PSUCAPSTONE2016GSMGROUP/SMSProject/FullSizeRender.jpg.jpeg

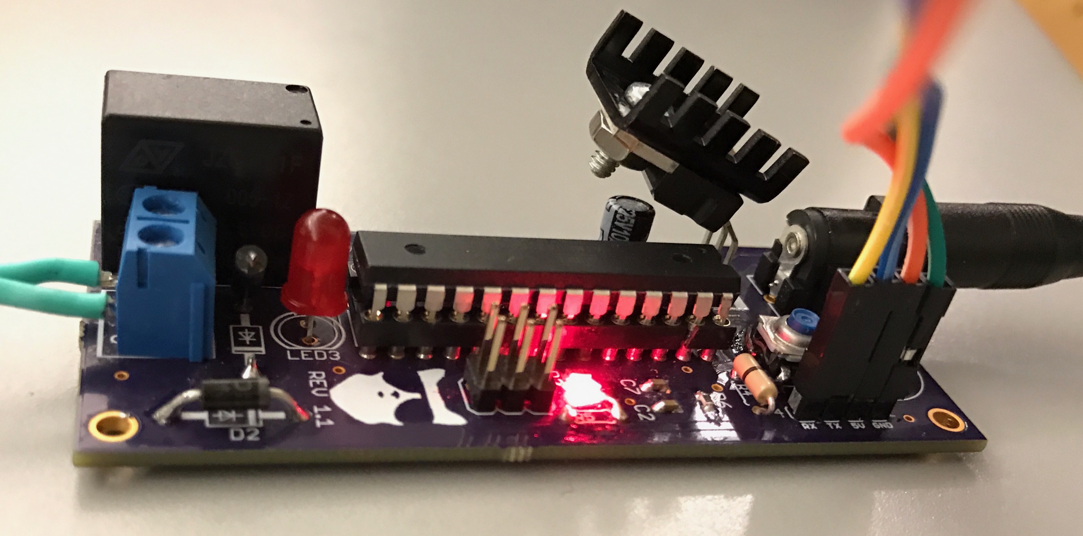
FullSizeRender.jpg.jpeg
