PSUCAPSTONE2016GSMGROUP/SMSProject/README.md

# SMSProject

This is a test of adding some code to the initial README.md file in the "master" branch.
Changes are being made in the readme-edits branch which was just created.
