PSUCAPSTONE2016GSMGROUP/SMSProject/Images/Bottom OSH Park .png

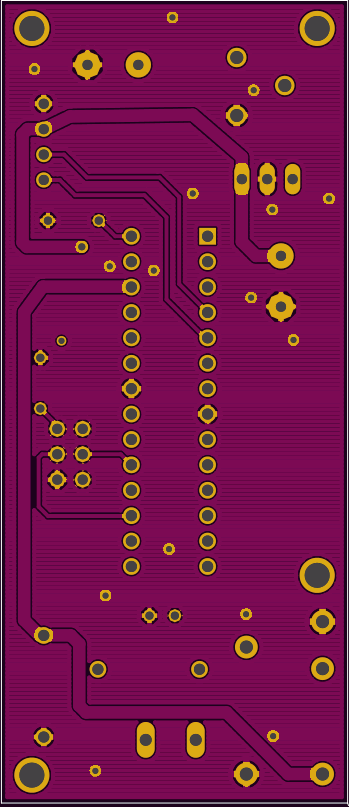
Images/Bottom OSH Park .png
