PSUCAPSTONE2016GSMGROUP/SMSProject/Images/Bottom-Rev1.1.png

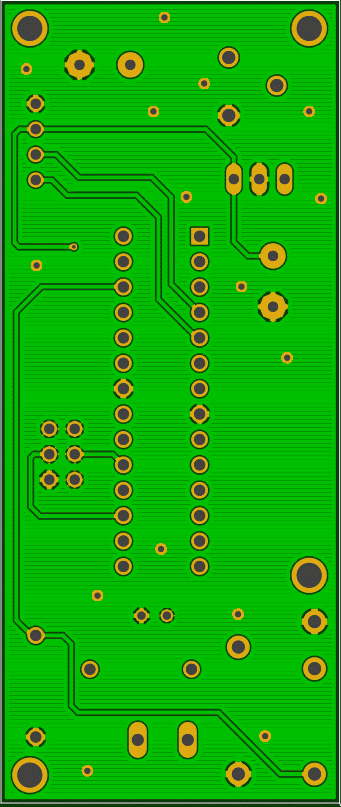
Images/Bottom-Rev1.1.png
