PSUCAPSTONE2016GSMGROUP/SMSProject/Images/COOL-CAT.bmp

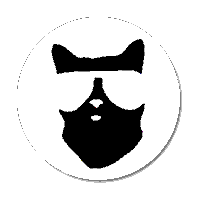
Images/COOL-CAT.bmp
