PSUCAPSTONE2016GSMGROUP/SMSProject/Images/Top-OSH Park.png

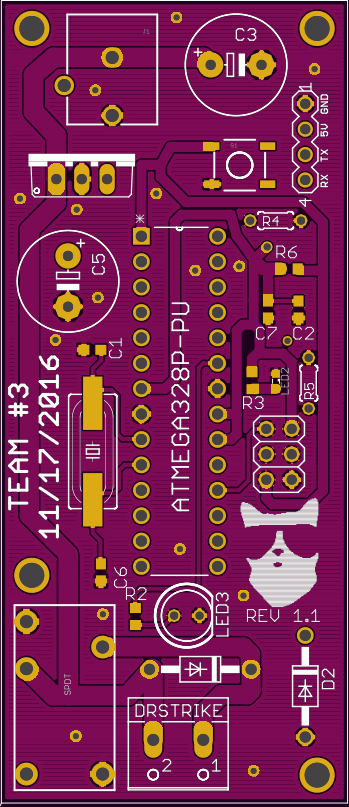
Images/Top-OSH Park.png
