PSUCAPSTONE2016GSMGROUP/SMSProject/Images/Top-Rev1.1.png

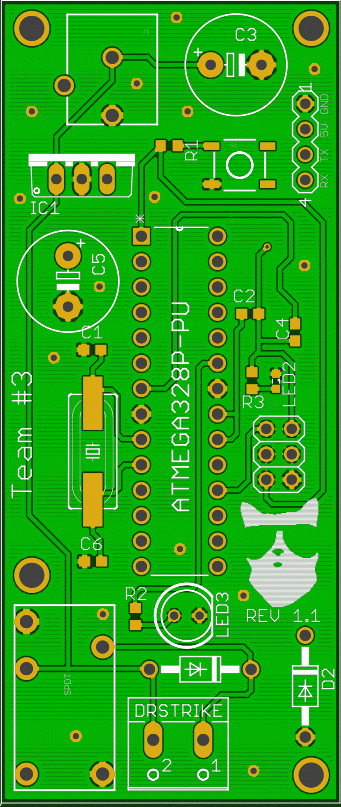
Images/Top-Rev1.1.png
