PSUCAPSTONE2016GSMGROUP/SMSProject/T03-BOM.xls

 | BOM: Group 3 | Rev: 4
Qty | Value | Device | Package | Parts | Description | Link | Price (each) | Price (total)
1 | N/A | LED5MM | LED5MM | LED3 | 5MM LED | Sparkfun (https://www.sparkfun.com/products/9590) | $0.35 | $0.35
1 | N/A | LEDSML0603 | SML0603 | LED2 | SURFACE MOUNT LED | Digikey (http://www.digikey.com/product-detail/en/lite-on-inc/LTST-C191KRKT/160-1447-1-ND/386836) | $0.21 | $0.21
1 | N/A | W237-102 | W237-102 | DRSTRIKE | WAGO SCREW CLAMP | Sparkfun (https://www.sparkfun.com/products/8084) | $0.95 | $0.95
1 | 10k | R-US_R0603 | R0603 | R1 | RESISTOR | Digikey (http://www.digikey.com/product-detail/en/stackpole-electronics-inc/RMCF0603JT10K0/RMCF0603JT10K0CT-ND/1943191) | $0.10 | $0.10
2 | 10u | CPOL-EUE5-10.5 | E5-10,5 | C3, C5 | POLARIZED CAPACITOR | Sparkfun (https://www.sparkfun.com/products/523) | $0.45 | $0.90
1 | 16M | CRYSTALHC49UP | HC49UP | Q2 | CRYSTAL | Digikey (http://www.digikey.com/product-detail/en/abracon-llc/ABLS-16.000MHZ-B4-T/535-10226-1-ND/2184261) | $0.21 | $0.21
2 | 1N4004 | 1N4004 | DO41-10 | D1 | DIODE | Mouser (http://www.mouser.com/ProductDetail/Diodes-Incorporated/1N4007-T/?qs=e%2FRqmsgwm9iVtgJYUW23AA%3D%3D) | $0.13 | $0.26
2 | 220 | R-US_R0603 | R0603 | R2, R3 | RESISTOR | Digikey (http://www.digikey.com/product-detail/en/vishay-dale/RCL0406220RFKEA/541-1944-1-ND/4741200) | $0.16 | $0.32
2 | 22p | C-EUC0603 | C0603 | C1, C6 | CAPACITOR | Mouser (http://www.mouser.com/ProductDetail/AVX/MM031A220JCT2A/) | $0.03 | $0.06
1 | 788TV | 788TV | TO220V | IC1 | Positive VOLTAGE REGULATOR | Sparkfun (https://www.sparkfun.com/products/12766) | $1.50 | $1.50
1 | ATMEGA328P-PU | ATMEGA328P-PU | DIP254P762X457-28 | U1 | 8-BIT MICROCONTROLLER | Sparkfun (https://www.sparkfun.com/products/9061) | $4.30 | $4.30
1 | AVR_SPI_PRG_62X3_LOCK | AVR_SPI_PRG_62X3_LOCK | 2X3_LOCK | J2 | AVR ISP 6 Pin | Sparkfun (https://www.sparkfun.com/products/12807) | $0.50 | $0.50
1 | POWER_JACKPTH_BREAD | POWER_JACKPTH_BREAD | POWER_JACK_PTH_BREAD | J1 | POWER JACK | Sparkfun (https://www.sparkfun.com/products/10811) | $0.95 | $0.95
1 | RELAYPTH4 | RELAYPTH4 | RELAY-JZC | SPDT | SPDT relay (COM-00101) | Sparkfun (https://www.sparkfun.com/products/100) | $1.95 | $1.95
1 | TAC_SWITCHSMD | TAC_SWITCHSMD | TACTILE-SWITCH-SMD | S1 | Momentary Switch | Sparkfun (https://www.sparkfun.com/products/97) | $0.35 | $0.35
1 | N/A | UHPPOTE ELECTRIC STRIKE | N/A | N/A | ELECTRIC DOOR STRIKE | Amazon (https://www.amazon.com/dp/B00V45GWTI/ref=nav_timeline_asin?_encoding=UTF8&psc=1) | $24.20 | $24.20
1 | N/A | GSM GPRS | N/A | N/A | SAINSMART SMALL GSM GPRS SIM900 | Amazon (https://www.amazon.com/gp/product/B00TEUAJMQ/ref=oh_aui_detailpage_o03_s00?ie=UTF8&psc=1) | $28.99 | $28.99
2 | 100n | C-EUC0603 | C0603 | C2,C7 | CAPACITOR | Mouser (http://www.mouser.com/ProductDetail/Murata-Electronics/GRM188R71E104KA01D/?qs=kZszf6EFsb%2BcS4JW42Ze0A==) | $0.02 | $0.04
2 | 0 | R-US_0204/5 (R-US_) | 0204/5 | R4,R5 | RESISTOR | Digikey (http://www.digikey.com/product-detail/en/yageo/ZOR-25-B-52-0R/0.0QBK-ND/18794) | $0.07 | $0.14
1 | N/A | N/A | N/A | N/A | 12V REGULATED POWERSUPPLY | BLMS (http://www.bitcheslovemyswitches.com/) | $7.00 | $7.00
1 | N/A | N/A | N/A | N/A | PRINTED CIRCUIT BOARD | OSH Park (https://oshpark.com/) | 5.41 | $5.41
 |  |  |  |  |  | TOTAL COST PER UNIT: |  | $78.69
