PSUCAPSTONE2016GSMGROUP/SMSProject/T03-GSM-Schematic.brd

## EAGLE design T03-GSM-Schematic.brd (2016-11-17)

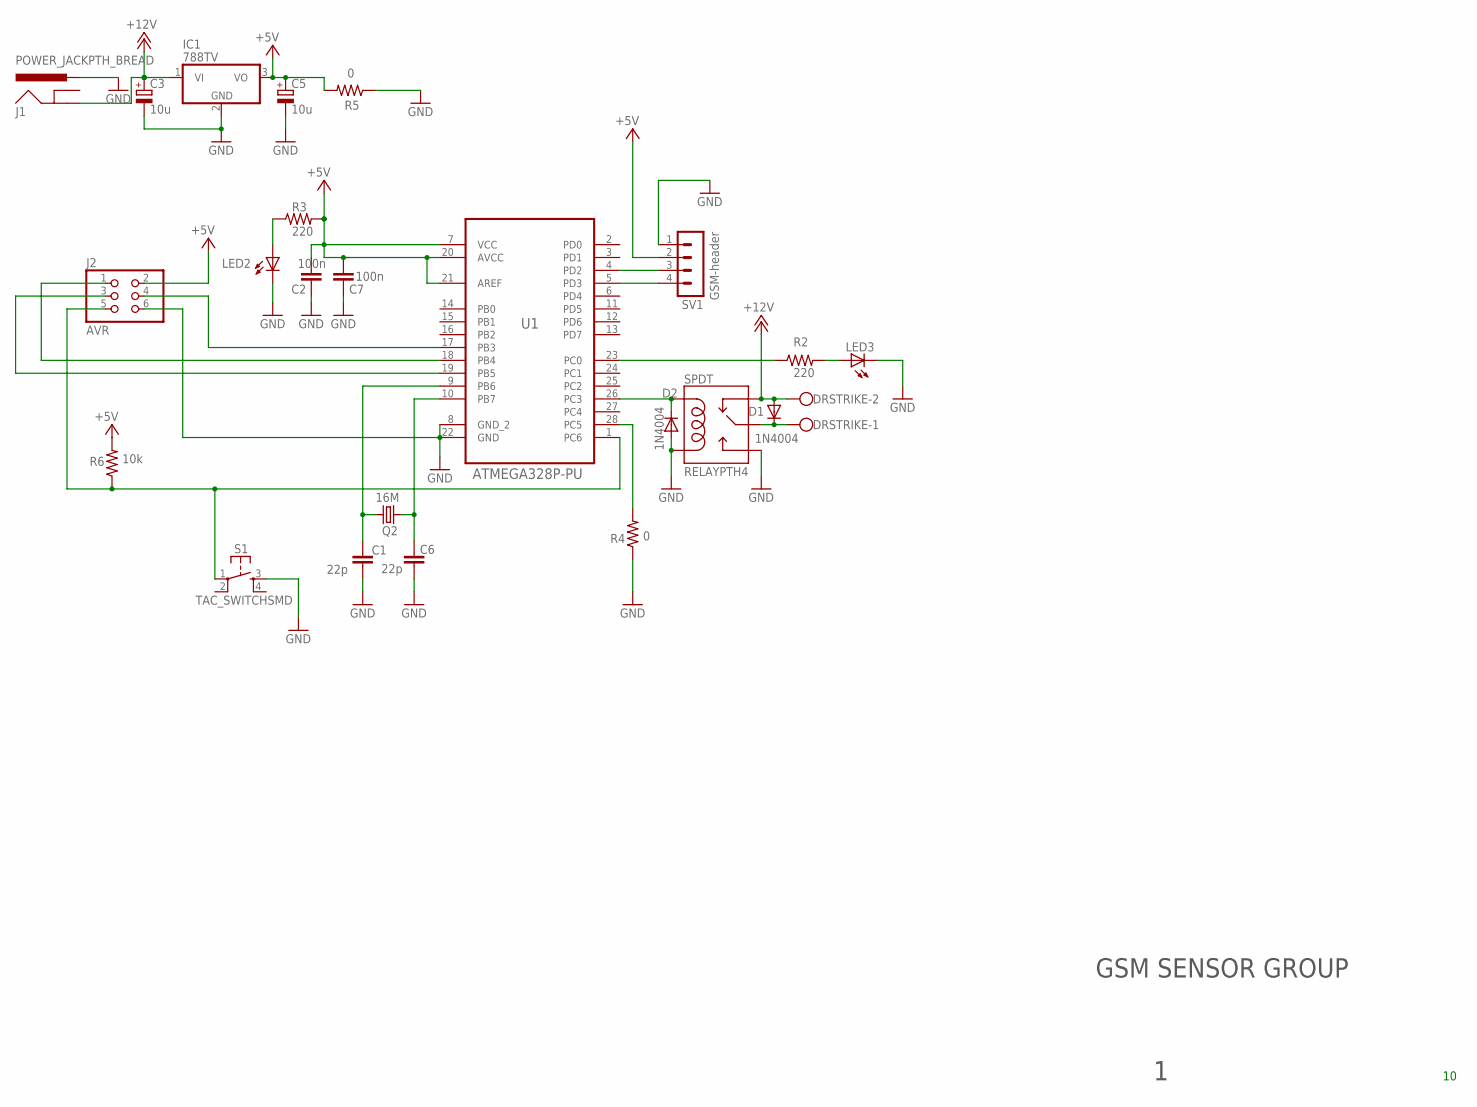
[picture p11: schematic T03-GSM-Schematic.sch]

Parts:
C1, C6: 22p; C0603
C2, C7: 100n; C0603
C3, C5: 10u; E5-10,5
D1, D2: 1N4004; DO41-10
DRSTRIKE: W237-102
IC1: 788TV; TO220V
J1: POWER_JACKPTH_BREAD; POWER_JACK_PTH_BREAD
J2: AVR; 2X03
LED2: LEDSML0603; SML0603
LED3: LED5MM
Q2: 16M; HC49UP
R2, R3: 220; R0603
R4, R5: 0; 0204/5
R6: 10k; R0603
S1: TAC_SWITCHSMD; TACTILE-SWITCH-SMD
SPDT: RELAYPTH4; RELAY-JZC
SV1: GSM-header; MA04-1
U1: ATMEGA328P-PU; DIP254P762X457-28

Connections:
+5V: C2.2, C5.+, C7.2, IC1.3 (VO), J2.2, R3.2, R5.2, R6.2, SV1.2, U1.7 (VCC), U1.20 (AVCC), U1.21 (AREF)
+12V: C3.+, D1.A, DRSTRIKE.2, IC1.1 (VI), J1.GND, SPDT.2 (NC)
GND: C1.2, C2.1, C3.-, C5.-, C6.2, C7.1, D2.A, IC1.2 (GND), J1.PWR, J2.6, LED2.C, LED3.K (C), R4.1, R5.1, S1.3, SPDT.1 (COIL2), SPDT.3 (NO), SV1.1, U1.8 (GND_2), U1.22 (GND)
unnamed: J2.5, R6.1, S1.1, U1.1 (PC6)
unnamed: LED2.A, R3.1
unnamed: D1.C, DRSTRIKE.1, SPDT.4 (MAIN)
unnamed: J2.3, U1.19 (PB5)
unnamed: LED3.A, R2.2
unnamed: J2.4, U1.17 (PB3)
unnamed: J2.1, U1.18 (PB4)
unnamed: R2.1, U1.23 (PC0)
unnamed: R4.2, U1.28 (PC5)
unnamed: D2.C, SPDT.5 (COIL1), U1.26 (PC3)
unnamed: C1.1, Q2.2, U1.9 (PB6)
unnamed: C6.1, Q2.1, U1.10 (PB7)
RX: SV1.4, U1.5 (PD3)
TX: SV1.3, U1.4 (PD2)

Notes on the sheet:
GSM SENSOR GROUP

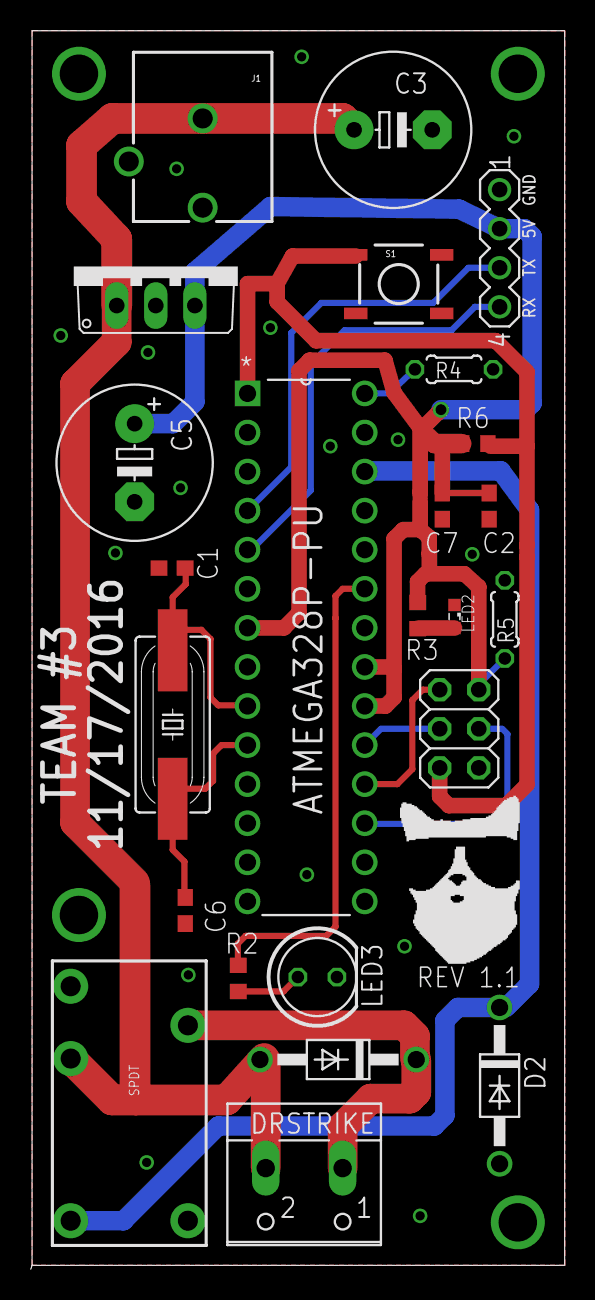
[picture p12: board T03-GSM-Schematic.brd from above]

Board: 2 copper layers, 34.6 x 80.3 mm, 24 parts (0 on the bottom side), 17 nets.
