PSUCAPSTONE2016GSMGROUP/SMSProject/(commit log)

2016-11-03 Cleaned up the schematic and fixed ERC errors
    [GSM Schematic.sch]
2016-11-03 Update GSM Schematic.sch
    [GSM Schematic.sch]
2016-11-05 Add files via upload
    Fixed the relay to door strike connection and replaced terminals with 237-102 WAGO terminal blocks
    [GSM Schematic.sch]
2016-11-07 updated the Schematic and changed PCB layout
    Updated the Schematic and included a surface mount for the Voltage regulator and changed the layout of the PCB and added a logo to it
    [GSM Schematic.brd, GSM Schematic.sch]
2016-11-08 Changed the logo location and added Revision #
    DRC errors down to 49 (All of the errors are Stop Errors)
    [GSM Schematic.brd]
2016-11-08 Arranged names for components
    [GSM Schematic.brd]
2016-11-08 Fixed DRC errors - Down to 10 errors
    [GSM Schematic.brd]
2016-11-09 Add files via upload
    Added diode to door strike output and cleaned up breadboard lines.
    Also solved consistency errors
    [GSM Schematic.sch]
2016-11-09 Made board and schematic consistent - no ERC erros
    [GSM Schematic.brd, GSM Schematic.sch]
2016-11-09 Fixed some DRC errors
    Down to 10 errors again
    [GSM Schematic.brd]
2016-11-09 timed and added mounting holes
    [GSM Schematic.brd]
2016-11-10 Fixed DRC errors and added dimensions
    [GSM Schematic.brd]
2016-11-10 Renamed file to meet the specification
    [T03-GSM-Schematic.brd]
2016-11-10 changed the Power Jack to through hole
    [T03-GSM-Schematic.brd, T03-GSM-Schematic.sch]
2016-11-10 Being replaced with T03-GSM-Schematic.sch
    [GSM Schematic.sch]
2016-11-10 Switched power + and - on power jack
    [T03-GSM-Schematic.brd, T03-GSM-Schematic.sch]
2016-11-13 Add files via upload
    Bill of materials: Rev. 1
    [T03-BOM.xlsx]
2016-11-13 Add files via upload
    Prices and links to parts added.
    [T03-BOM.xlsx]
2016-11-14 Change the Voltage regulator to through hole
    [T03-GSM-Schematic.brd, T03-GSM-Schematic.sch]
2016-11-14 Fixed outline around board
    [T03-GSM-Schematic.brd]
2016-11-14 Gerber Files initial upload
    [boardoutline.gko, bottomlayer.GBL, bottomsilkscreen.gbo, bottomsoldermask.gbs, drills.xln, toplayer.GTL, topsilkscreen.gto, topsoldermask.gts]
2016-11-14 Fixed minor issue with board outline
    [T03-GSM-Schematic.brd]
2016-11-15 Added terminal points for GSM module
    5V and GND
    [T03-GSM-Schematic.brd, T03-GSM-Schematic.sch]
2016-11-15 Moved the power jack position
    [T03-GSM-Schematic.brd]
2016-11-15 Gerber files for the new board layout
    [boardoutline.gko, bottomlayer.GBL, bottomsilkscreen.gbo, bottomsoldermask.gbs, drills.xln, toplayer.GTL, topsilkscreen.gto, topsoldermask.gts]
2016-11-15 Gerber files for latest board file
2016-11-15 Changed terminal points component
    [T03-GSM-Schematic.brd]
2016-11-15 Gerber files for changes i made in the layout
2016-11-16 Add files via upload
    gnd orientation fixed.
    [T03-GSM-Schematic.sch]
2016-11-16 Add files via upload
    Fixed power jack pin on schematic. There is an inconsistency with the board and schematic
    [T03-GSM-Schematic.sch]
2016-11-16 fixed Consistency error with GSM terminal points
    [T03-GSM-Schematic.sch]
2016-11-16 fixed power jack connection
    [T03-GSM-Schematic.sch]
2016-11-16 Add files via upload
    added flyback diode, bypass caps. No board level work done yet.
    [T03-GSM-Schematic.brd, T03-GSM-Schematic.sch]
2016-11-16 Changed the layout of the PCB board
    [T03-GSM-Schematic.brd, T03-GSM-Schematic.sch]
2016-11-16 Add files via upload
    Added test point, fixed ERC error.
    More updates to come.
    [T03-GSM-Schematic.brd, T03-GSM-Schematic.sch]
2016-11-16 Add files via upload
    Added another test point after the voltage limiter and increased line thickness on power leads
    [T03-GSM-Schematic.brd, T03-GSM-Schematic.sch]
2016-11-17 Made the 5V line thicker
    [T03-GSM-Schematic.brd]
2016-11-17 Add files via upload
    Final Revision.
    No DRC or ERC errors.
    Updates:
    Power lines thickened
    Power capacitor orientation fixed
    Reset pull-up resistor added
    Power symbols used in schematic
    [T03-GSM-Schematic.brd, T03-GSM-Schematic.sch]
2016-11-17 Made the board litter wider
    [T03-GSM-Schematic.brd]
2016-11-18 Add files via upload
    Updated BOM to include 0 ohm test resistors, 100n capacitors, and updated quantities of parts
    [T03-BOM.xls]
2016-11-18 Delete T03-BOM.xlsx
    New updated BOM created.
    [T03-BOM.xlsx]
2016-12-02 Add files via upload
    Added door strike, GSM Module, and power supply prices to overall cost
    [T03-BOM.xls]
2016-12-04 Add files via upload
    Fixed duplicates, updated prices, added PCB cost
    [T03-BOM.xls]
